RainyDayHiker/splitflap/3d/my_final_stl/Chainlink Driver Mount Left.stl

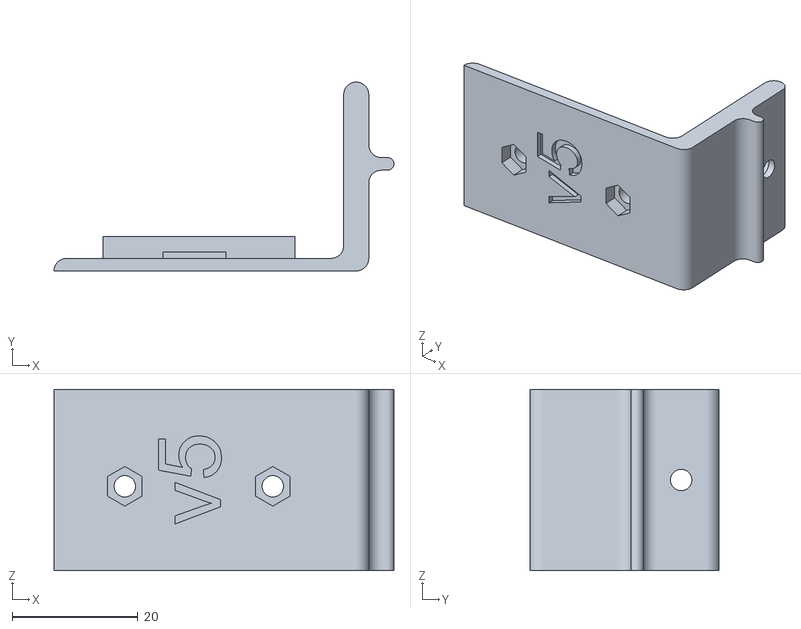
[picture p1: CAD file, 2025-09-09]
3d/my_final_stl/Chainlink Driver Mount Left.stl
54.0 x 30.0 x 28.8
