RainyDayHiker/splitflap/3d/my_final_stl/MainFlaps/flap_00/00_letter_back.stl

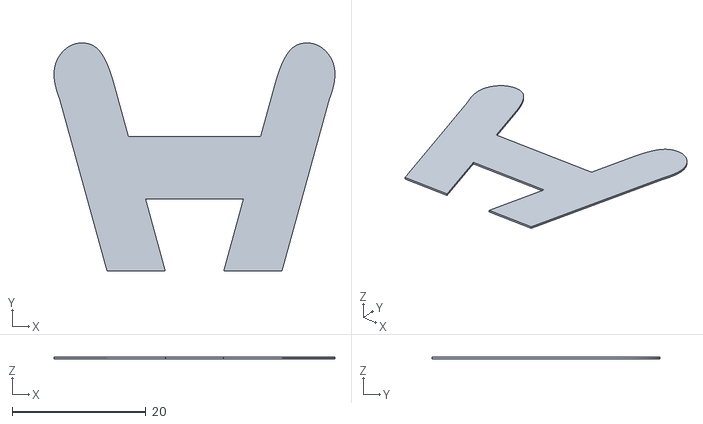
[picture p2: CAD file, 2025-06-13]
3d/my_final_stl/MainFlaps/flap_00/00_letter_back.stl
42.0 x 34.1 x 0.3
