RainyDayHiker/splitflap/3d/my_final_stl/MainFlaps/flap_01/01_letter_front.stl

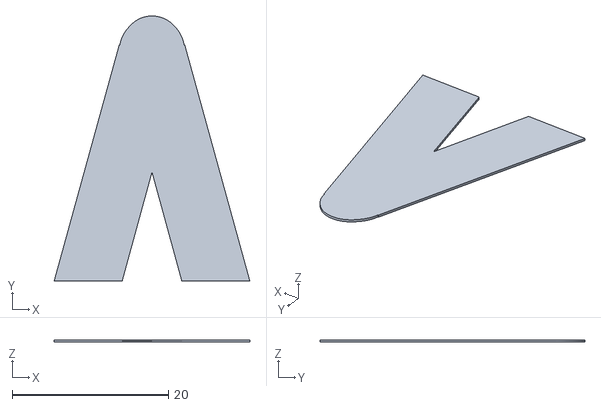
[picture p3: CAD file, 2025-06-13]
3d/my_final_stl/MainFlaps/flap_01/01_letter_front.stl
25.0 x 33.9 x 0.3
