RainyDayHiker/splitflap/3d/my_final_stl/MainFlaps/flap_02/02_flap.stl

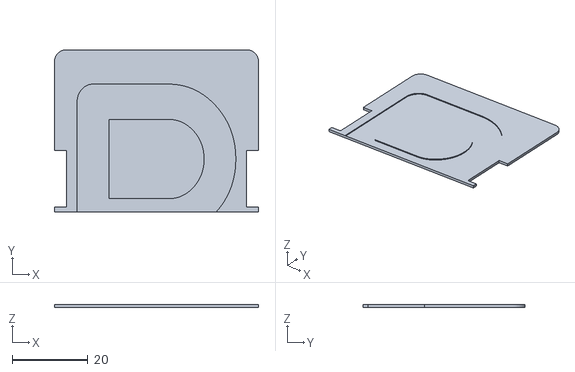
[picture p4: CAD file, 2025-06-13]
3d/my_final_stl/MainFlaps/flap_02/02_flap.stl
54.0 x 43.0 x 0.762
