RainyDayHiker/splitflap/3d/my_final_stl/MainFlaps/flap_03/03_letter_front.stl

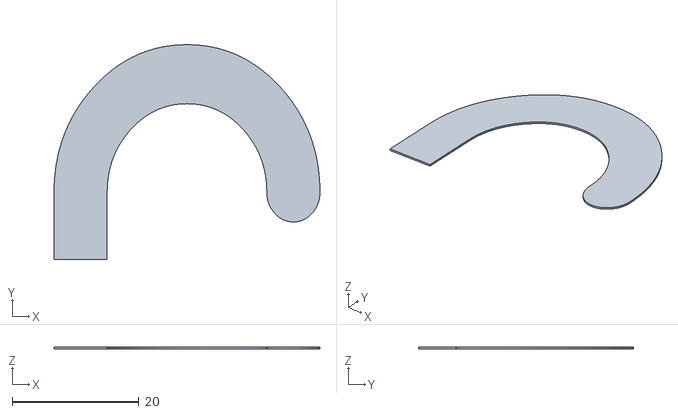
[picture p5: CAD file, 2025-06-13]
3d/my_final_stl/MainFlaps/flap_03/03_letter_front.stl
42.0 x 33.9 x 0.3
