RainyDayHiker/splitflap/3d/my_final_stl/MainFlaps/flap_05/05_letter_back.stl

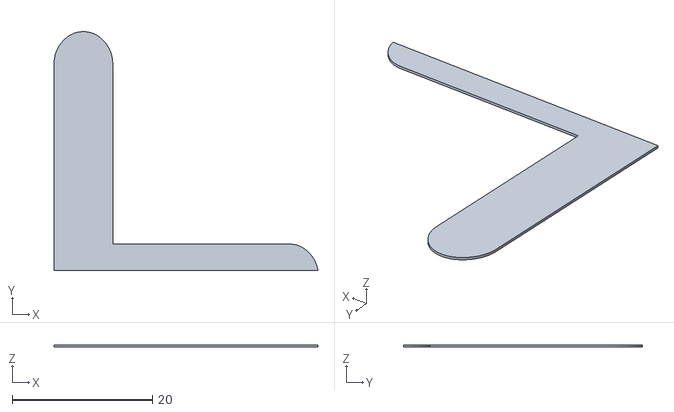
[picture p7: CAD file, 2025-06-13]
3d/my_final_stl/MainFlaps/flap_05/05_letter_back.stl
37.7 x 34.1 x 0.3
