RainyDayHiker/splitflap/3d/my_final_stl/MainFlaps/flap_13/13_letter_back.stl

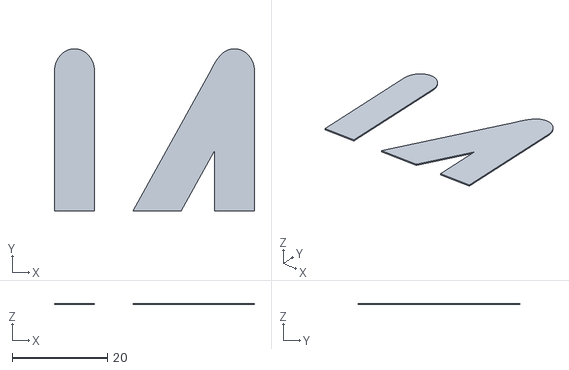
[picture p9: CAD file, 2025-06-13]
3d/my_final_stl/MainFlaps/flap_13/13_letter_back.stl
42.0 x 34.1 x 0.3
