RainyDayHiker/splitflap/3d/my_final_stl/MainFlaps/flap_15/15_letter_back.stl

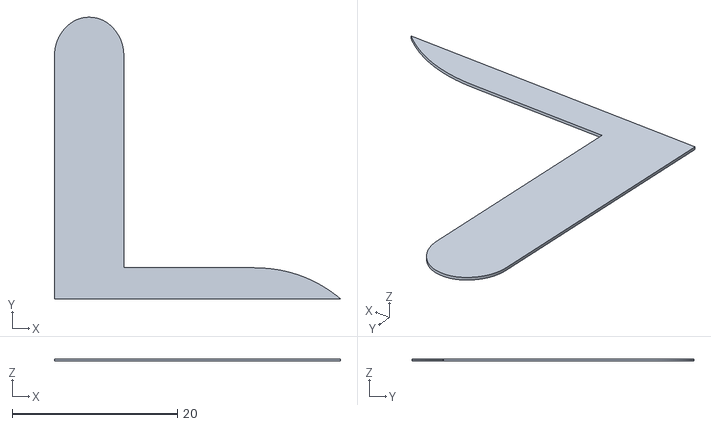
[picture p10: CAD file, 2025-06-13]
3d/my_final_stl/MainFlaps/flap_15/15_letter_back.stl
34.6 x 34.1 x 0.3
