RainyDayHiker/splitflap/3d/my_final_stl/MainFlaps/flap_24/24_letter_back.stl

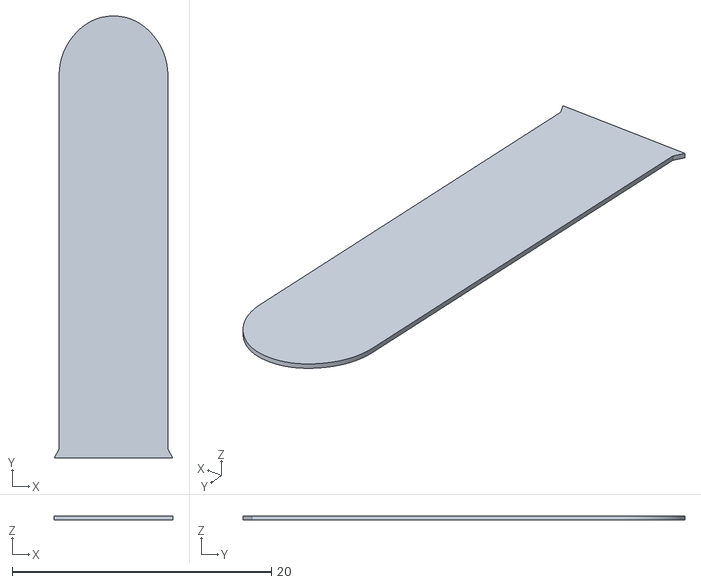
[picture p14: CAD file, 2025-06-13]
3d/my_final_stl/MainFlaps/flap_24/24_letter_back.stl
9.16 x 34.1 x 0.3
