RainyDayHiker/splitflap/3d/my_final_stl/MainFlaps/flap_39/39_letter_back.stl

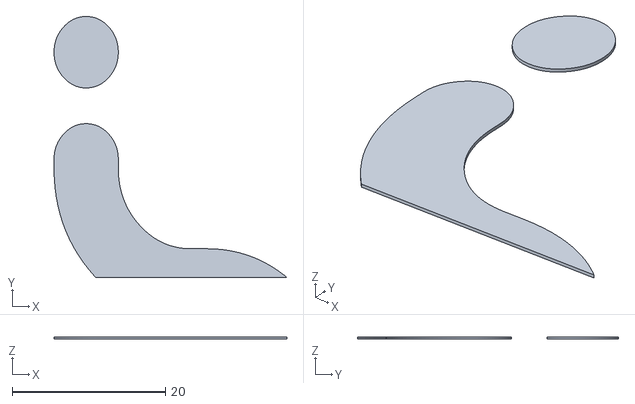
[picture p16: CAD file, 2025-06-13]
3d/my_final_stl/MainFlaps/flap_39/39_letter_back.stl
30.4 x 34.1 x 0.3
