RainyDayHiker/splitflap/3d/my_final_stl/MainFlaps/flap_46/46_letter_back.stl

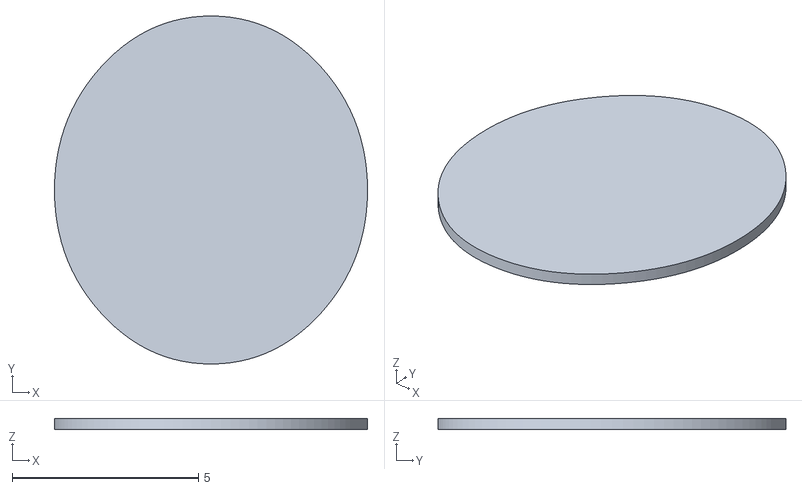
[picture p18: CAD file, 2025-08-20]
3d/my_final_stl/MainFlaps/flap_46/46_letter_back.stl
8.40 x 9.33 x 0.3
