RainyDayHiker/splitflap/3d/my_final_stl/MainFlaps/flap_50/50_letter_back.stl

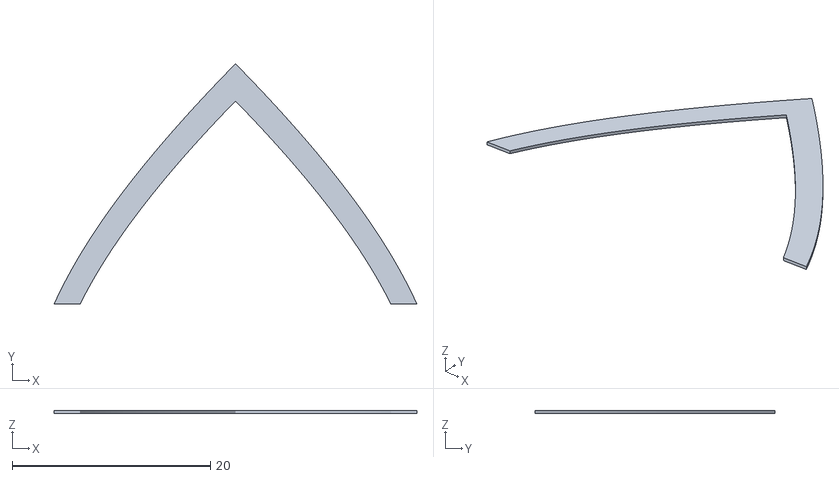
[picture p19: CAD file, 2025-06-13]
3d/my_final_stl/MainFlaps/flap_50/50_letter_back.stl
36.6 x 24.3 x 0.3
