RainyDayHiker/splitflap/3d/my_final_stl/MainFlaps/flaps_printbed_red_x7.3mf

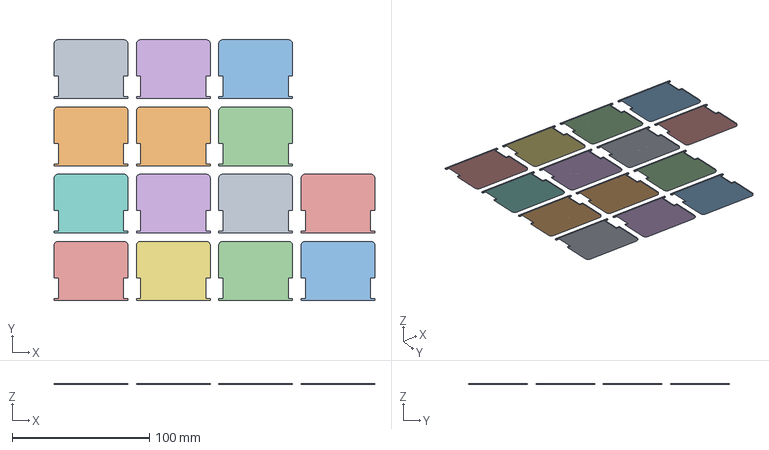
[picture p20: CAD file, 2025-08-25]
3d/my_final_stl/MainFlaps/flaps_printbed_red_x7.3mf
234.0 x 190.0 x 0.782 mm
37_flap
38_flap
