RainyDayHiker/splitflap/3d/my_final_stl/WeatherFlaps/flap_26/26_letter_back.stl

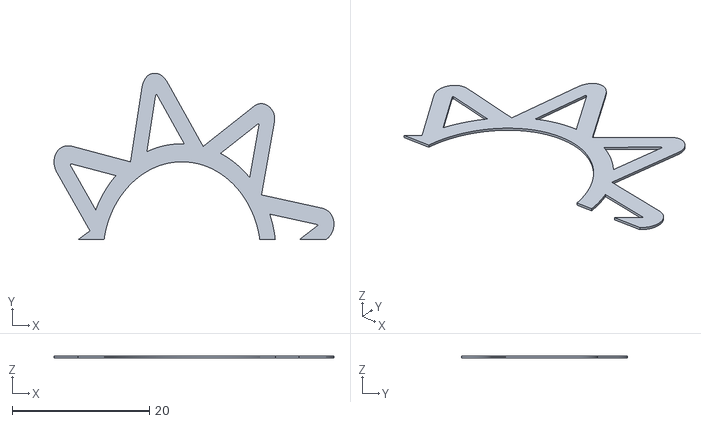
[picture p21: CAD file, 2025-06-13]
3d/my_final_stl/WeatherFlaps/flap_26/26_letter_back.stl
40.8 x 24.3 x 0.3
