RainyDayHiker/splitflap/3d/my_final_stl/WeatherFlaps/flap_37/37_letter_back.stl

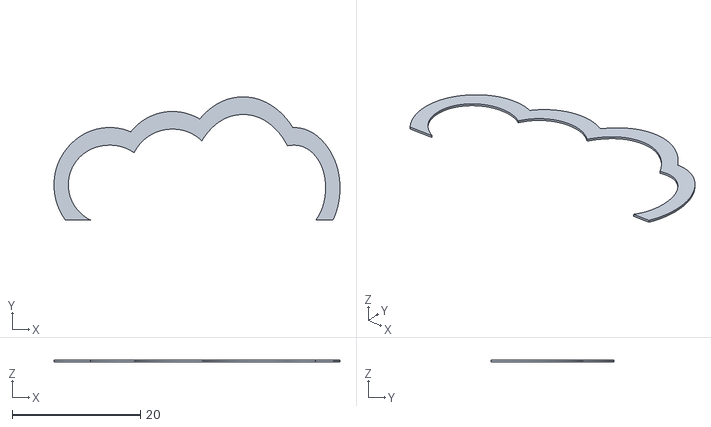
[picture p22: CAD file, 2025-06-13]
3d/my_final_stl/WeatherFlaps/flap_37/37_letter_back.stl
44.7 x 19.3 x 0.3
