RainyDayHiker/splitflap/3d/my_final_stl/WeatherFlaps/flap_45/45_letter_back.stl

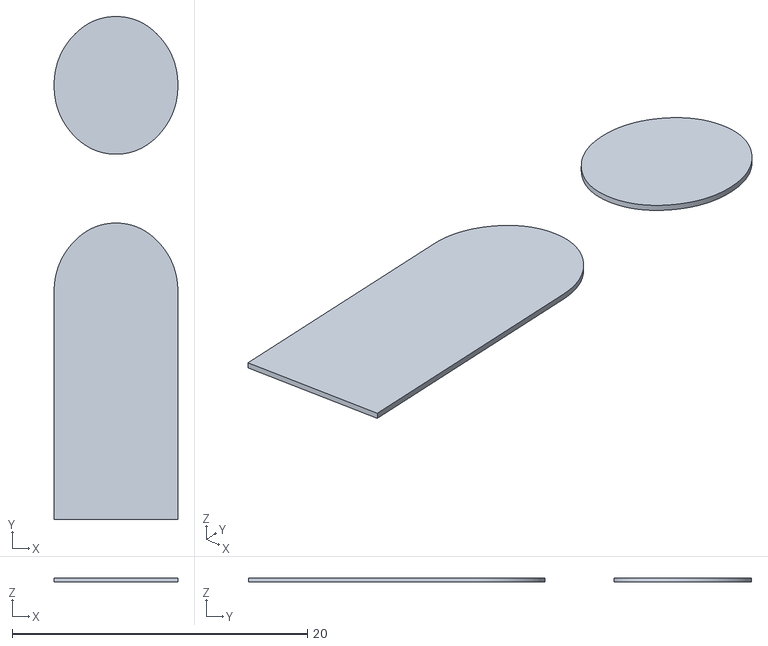
[picture p23: CAD file, 2025-06-13]
3d/my_final_stl/WeatherFlaps/flap_45/45_letter_back.stl
8.40 x 34.1 x 0.3
