RainyDayHiker/splitflap/3d/my_final_stl/WeatherFlaps/flap_48/48_letter_front.stl

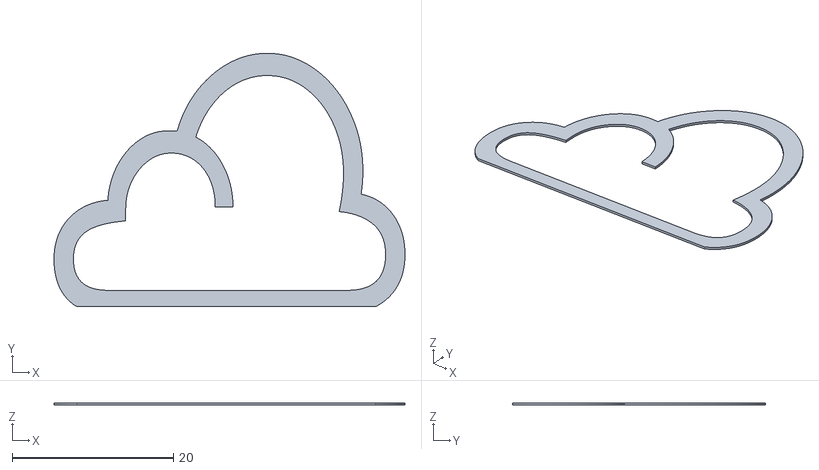
[picture p24: CAD file, 2025-06-13]
3d/my_final_stl/WeatherFlaps/flap_48/48_letter_front.stl
43.5 x 31.4 x 0.3
