RainyDayHiker/splitflap/3d/my_final_stl/WeatherFlaps/flap_49/49_letter_back.stl

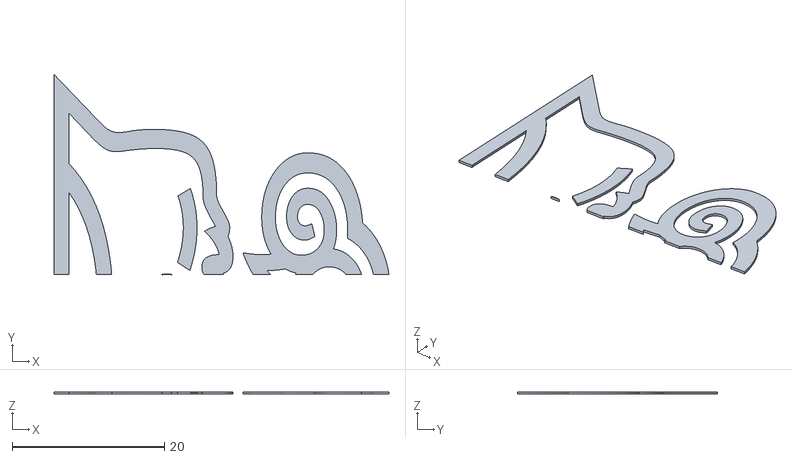
[picture p25: CAD file, 2025-06-13]
3d/my_final_stl/WeatherFlaps/flap_49/49_letter_back.stl
44.0 x 26.3 x 0.3
