RainyDayHiker/splitflap/3d/my_final_stl/WeatherFlaps/flap_50/50_flap.stl

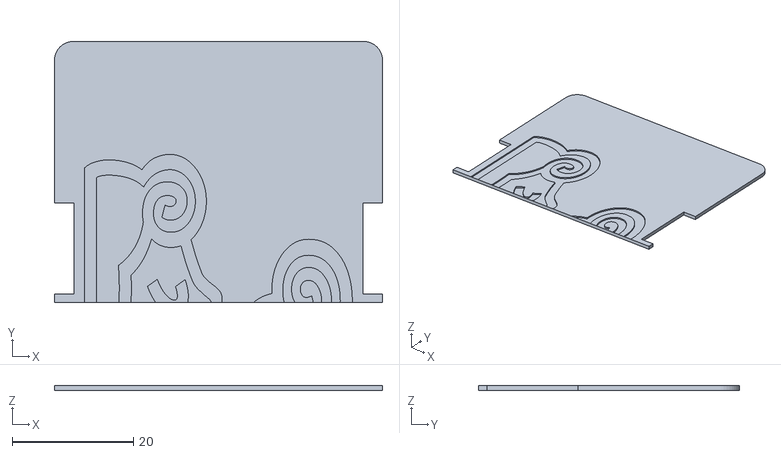
[picture p26: CAD file, 2025-06-13]
3d/my_final_stl/WeatherFlaps/flap_50/50_flap.stl
54.0 x 43.0 x 0.762
