RainyDayHiker/splitflap/3d/my_final_stl/WeatherFlaps/flaps_printbed_2.3mf

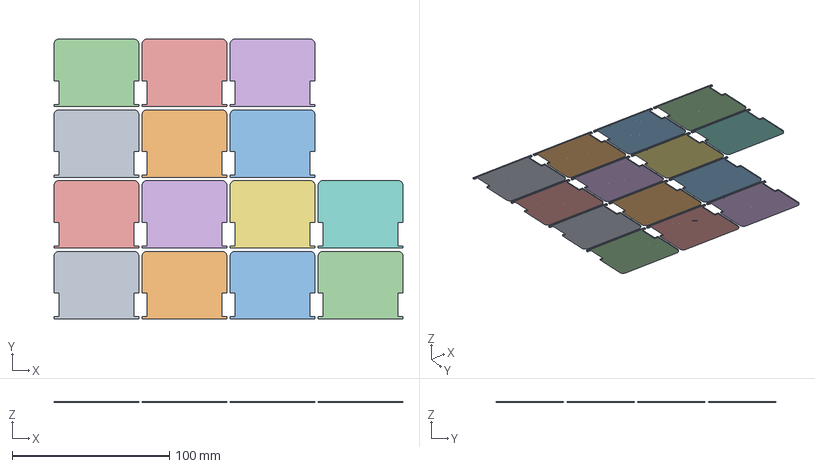
[picture p27: CAD file, 2025-08-20]
3d/my_final_stl/WeatherFlaps/flaps_printbed_2.3mf
222.0 x 178.0 x 0.782 mm
14_flap
15_flap
16_flap
17_flap
18_flap
19_flap
20_flap
21_flap
22_flap
23_flap
24_flap
25_flap
26_flap
27_flap
