RainyDayHiker/splitflap/3d/my_final_stl/Frame - Left.stl

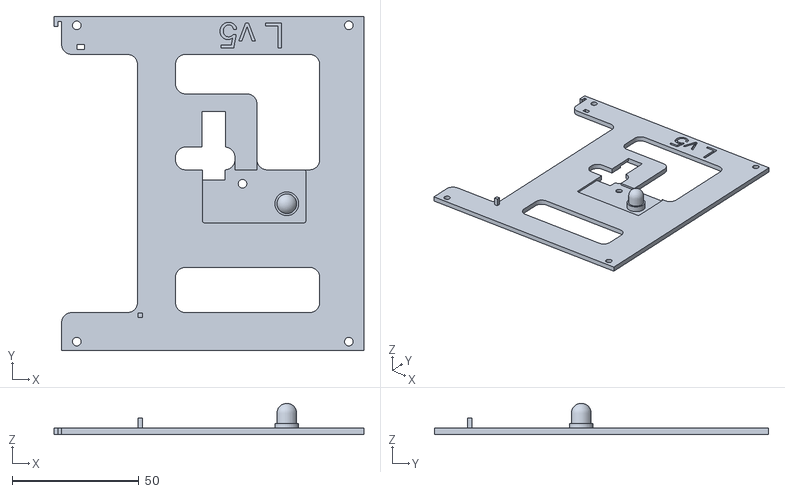
[picture p28: CAD file, 2025-09-09]
3d/my_final_stl/Frame - Left.stl
122.5 x 132.0 x 12.3
