RainyDayHiker/splitflap/3d/my_final_stl/MainFlaps/flap_10/10_letter_front.stl

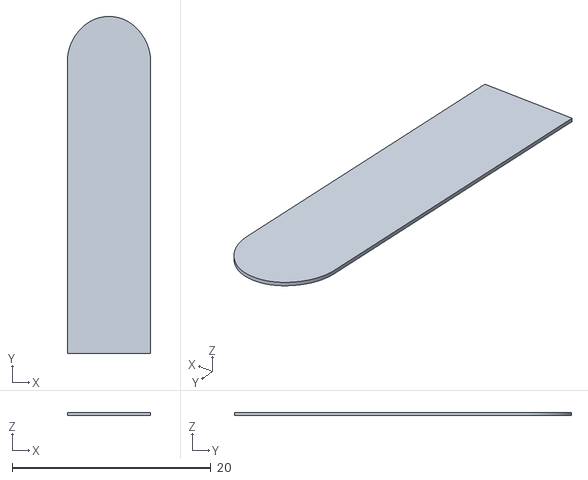
[picture p29: CAD file, 2025-06-13]
3d/my_final_stl/MainFlaps/flap_10/10_letter_front.stl
8.40 x 33.9 x 0.3
