RainyDayHiker/splitflap/3d/my_final_stl/MainFlaps/flap_16/16_letter_back.stl

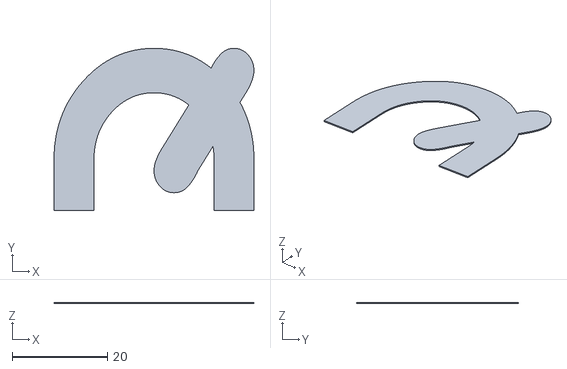
[picture p31: CAD file, 2025-06-13]
3d/my_final_stl/MainFlaps/flap_16/16_letter_back.stl
42.0 x 34.1 x 0.3
