RainyDayHiker/splitflap/3d/my_final_stl/MainFlaps/flap_22/22_letter_back.stl

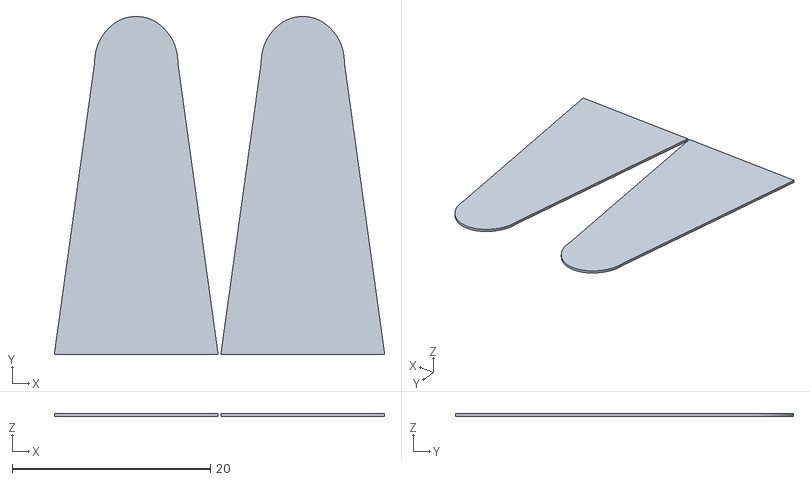
[picture p32: CAD file, 2025-06-13]
3d/my_final_stl/MainFlaps/flap_22/22_letter_back.stl
33.3 x 34.1 x 0.3
