RainyDayHiker/splitflap/3d/my_final_stl/MainFlaps/flap_26/26_letter_back.stl

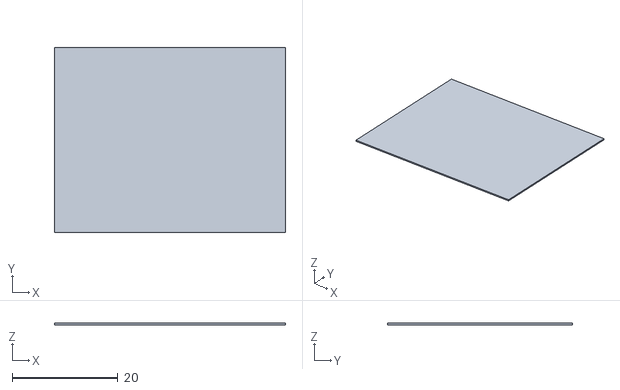
[picture p33: CAD file, 2025-06-13]
3d/my_final_stl/MainFlaps/flap_26/26_letter_back.stl
43.6 x 34.9 x 0.3
