RainyDayHiker/splitflap/3d/my_final_stl/MainFlaps/flap_29/29_letter_front.stl

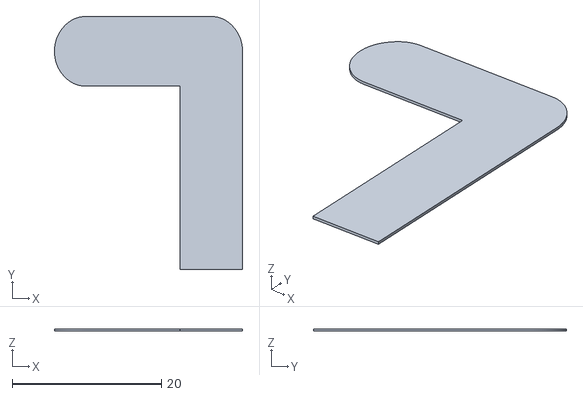
[picture p34: CAD file, 2025-06-13]
3d/my_final_stl/MainFlaps/flap_29/29_letter_front.stl
25.2 x 33.9 x 0.3
