RainyDayHiker/splitflap/3d/my_final_stl/MainFlaps/flap_32/32_letter_front.stl

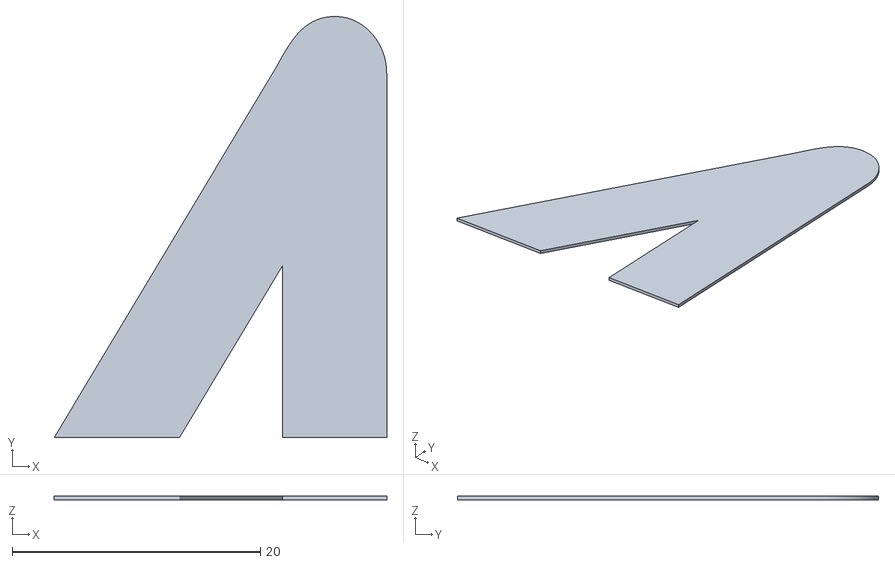
[picture p35: CAD file, 2025-06-13]
3d/my_final_stl/MainFlaps/flap_32/32_letter_front.stl
26.8 x 33.9 x 0.3
