RainyDayHiker/splitflap/3d/my_final_stl/MainFlaps/flap_38/38_letter_front.stl

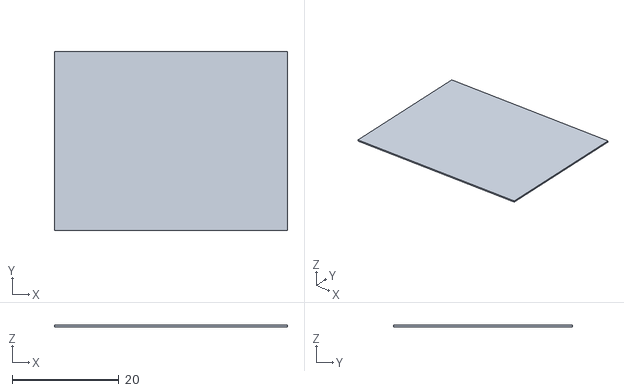
[picture p36: CAD file, 2025-06-13]
3d/my_final_stl/MainFlaps/flap_38/38_letter_front.stl
43.6 x 33.5 x 0.3
