RainyDayHiker/splitflap/3d/my_final_stl/MainFlaps/flap_40/40_letter_back.stl

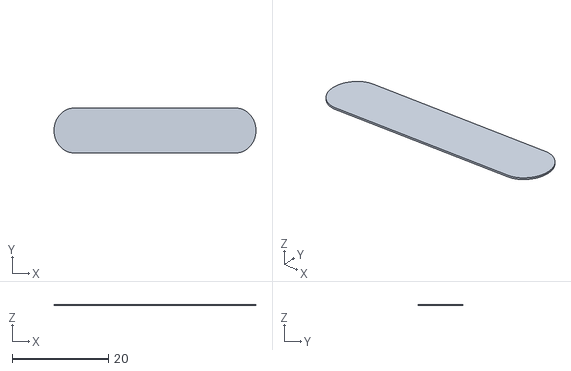
[picture p37: CAD file, 2025-06-18]
3d/my_final_stl/MainFlaps/flap_40/40_letter_back.stl
42.0 x 9.33 x 0.3
