RainyDayHiker/splitflap/3d/flap_characters.scad

// Original
//character_list = " ABCDEFGHIJKLMNOPQRSTUVWXYZg0123456789r.?-$'#yp,!@&w";
// Emoji
character_list = " ABCDEFGHIJKLMNOPQRSTUVWXYZg0123456789r.?-$'#,!:hijk";
// Weather
//character_list = " ABCDEFGHIJKLMNOPQRSTUVWXYZa0123456789b.?-$'#,!:cdef";

function get_character_list() = character_list;
