RainyDayHiker/splitflap/(list of files, cad)

Other CAD files:
3d/my_final_stl/MainFlaps/flap_07/07_letter_back.stl
3d/my_final_stl/MainFlaps/flap_08/08_flap.stl
3d/my_final_stl/MainFlaps/flap_09/09_flap.stl
3d/my_final_stl/MainFlaps/flap_10/10_flap.stl
3d/my_final_stl/MainFlaps/flap_11/11_letter_front.stl
3d/my_final_stl/MainFlaps/flap_12/12_flap.stl
3d/my_final_stl/MainFlaps/flap_14/14_letter_front.stl
3d/my_final_stl/MainFlaps/flap_17/17_letter_front.stl
3d/my_final_stl/MainFlaps/flap_18/18_flap.stl
3d/my_final_stl/MainFlaps/flap_19/19_flap.stl
3d/my_final_stl/MainFlaps/flap_21/21_letter_front.stl
3d/my_final_stl/MainFlaps/flap_22/22_flap.stl
3d/my_final_stl/MainFlaps/flap_25/25_flap.stl
3d/my_final_stl/MainFlaps/flap_26/26_flap.stl
3d/my_final_stl/MainFlaps/flap_27/27_flap.stl
3d/my_final_stl/MainFlaps/flap_28/28_letter_back.stl
3d/my_final_stl/MainFlaps/flap_29/29_flap.stl
3d/my_final_stl/MainFlaps/flap_30/30_flap.stl
3d/my_final_stl/MainFlaps/flap_31/31_flap.stl
3d/my_final_stl/MainFlaps/flap_32/32_flap.stl
3d/my_final_stl/MainFlaps/flap_33/33_letter_back.stl
3d/my_final_stl/MainFlaps/flap_35/35_letter_back.stl
3d/my_final_stl/MainFlaps/flap_36/36_letter_back.stl
3d/my_final_stl/MainFlaps/flap_37/37_letter_front.stl
3d/my_final_stl/MainFlaps/flap_38/38_flap.stl
3d/my_final_stl/MainFlaps/flap_40/40_flap.stl
3d/my_final_stl/MainFlaps/flap_41/41_letter_back.stl
3d/my_final_stl/MainFlaps/flap_42/42_flap.stl
3d/my_final_stl/MainFlaps/flap_43/43_flap.stl
3d/my_final_stl/MainFlaps/flap_44/44_flap.stl
3d/my_final_stl/MainFlaps/flap_47/47_letter_front.stl
3d/my_final_stl/MainFlaps/flap_48/48_flap.stl
3d/my_final_stl/MainFlaps/flap_49/49_flap.stl
3d/my_final_stl/MainFlaps/flap_51/51_flap.stl
3d/my_final_stl/WeatherFlaps/flap_00/00_flap.stl
3d/my_final_stl/WeatherFlaps/flap_02/02_letter_front.stl
3d/my_final_stl/WeatherFlaps/flap_03/03_flap.stl
3d/my_final_stl/WeatherFlaps/flap_04/04_letter_front.stl
3d/my_final_stl/WeatherFlaps/flap_05/05_letter_front.stl
3d/my_final_stl/WeatherFlaps/flap_07/07_flap.stl
3d/my_final_stl/WeatherFlaps/flap_08/08_letter_front.stl
3d/my_final_stl/WeatherFlaps/flap_10/10_flap.stl
3d/my_final_stl/WeatherFlaps/flap_11/11_letter_front.stl
3d/my_final_stl/WeatherFlaps/flap_12/12_flap.stl
3d/my_final_stl/WeatherFlaps/flap_13/13_flap.stl
3d/my_final_stl/WeatherFlaps/flap_14/14_flap.stl
3d/my_final_stl/WeatherFlaps/flap_15/15_letter_front.stl
3d/my_final_stl/WeatherFlaps/flap_16/16_flap.stl
3d/my_final_stl/WeatherFlaps/flap_17/17_letter_front.stl
3d/my_final_stl/WeatherFlaps/flap_18/18_letter_front.stl
3d/my_final_stl/WeatherFlaps/flap_19/19_flap.stl
3d/my_final_stl/WeatherFlaps/flap_20/20_letter_back.stl
3d/my_final_stl/WeatherFlaps/flap_21/21_letter_back.stl
3d/my_final_stl/WeatherFlaps/flap_22/22_flap.stl
3d/my_final_stl/WeatherFlaps/flap_23/23_letter_back.stl
3d/my_final_stl/WeatherFlaps/flap_24/24_flap.stl
3d/my_final_stl/WeatherFlaps/flap_25/25_letter_back.stl
3d/my_final_stl/WeatherFlaps/flap_27/27_flap.stl
3d/my_final_stl/WeatherFlaps/flap_28/28_flap.stl
3d/my_final_stl/WeatherFlaps/flap_29/29_letter_back.stl
3d/my_final_stl/WeatherFlaps/flap_30/30_letter_back.stl
3d/my_final_stl/WeatherFlaps/flap_31/31_flap.stl
3d/my_final_stl/WeatherFlaps/flap_32/32_letter_back.stl
3d/my_final_stl/WeatherFlaps/flap_33/33_letter_front.stl
3d/my_final_stl/WeatherFlaps/flap_35/35_flap.stl
3d/my_final_stl/WeatherFlaps/flap_36/36_letter_front.stl
3d/my_final_stl/WeatherFlaps/flap_38/38_flap.stl
3d/my_final_stl/WeatherFlaps/flap_39/39_flap.stl
3d/my_final_stl/WeatherFlaps/flap_40/40_flap.stl
3d/my_final_stl/WeatherFlaps/flap_41/41_letter_back.stl
3d/my_final_stl/WeatherFlaps/flap_42/42_flap.stl
3d/my_final_stl/WeatherFlaps/flap_43/43_flap.stl
3d/my_final_stl/WeatherFlaps/flap_44/44_flap.stl
3d/my_final_stl/WeatherFlaps/flap_47/47_flap.stl
3d/my_final_stl/WeatherFlaps/flap_51/51_flap.stl
3d/my_final_stl/MainFlaps/flap_00/00_flap.stl
3d/my_final_stl/MainFlaps/flap_01/01_flap.stl
3d/my_final_stl/MainFlaps/flap_02/02_letter_back.stl
3d/my_final_stl/MainFlaps/flap_03/03_letter_back.stl
3d/my_final_stl/MainFlaps/flap_04/04_letter_front.stl
3d/my_final_stl/MainFlaps/flap_05/05_letter_front.stl
3d/my_final_stl/MainFlaps/flap_06/06_flap.stl
3d/my_final_stl/MainFlaps/flap_08/08_letter_back.stl
3d/my_final_stl/MainFlaps/flap_09/09_letter_back.stl
3d/my_final_stl/MainFlaps/flap_11/11_letter_back.stl
3d/my_final_stl/MainFlaps/flap_13/13_flap.stl
3d/my_final_stl/MainFlaps/flap_14/14_flap.stl
3d/my_final_stl/MainFlaps/flap_15/15_flap.stl
3d/my_final_stl/MainFlaps/flap_17/17_letter_back.stl
3d/my_final_stl/MainFlaps/flap_18/18_letter_back.stl
3d/my_final_stl/MainFlaps/flap_19/19_letter_back.stl
3d/my_final_stl/MainFlaps/flap_20/20_flap.stl
3d/my_final_stl/MainFlaps/flap_21/21_flap.stl
3d/my_final_stl/MainFlaps/flap_23/23_flap.stl
3d/my_final_stl/MainFlaps/flap_24/24_letter_front.stl
3d/my_final_stl/MainFlaps/flap_25/25_letter_back.stl
3d/my_final_stl/MainFlaps/flap_27/27_letter_back.stl
3d/my_final_stl/MainFlaps/flap_28/28_letter_front.stl
3d/my_final_stl/MainFlaps/flap_30/30_letter_back.stl
3d/my_final_stl/MainFlaps/flap_31/31_letter_back.stl
3d/my_final_stl/MainFlaps/flap_33/33_flap.stl
3d/my_final_stl/MainFlaps/flap_34/34_flap.stl
3d/my_final_stl/MainFlaps/flap_35/35_flap.stl
3d/my_final_stl/MainFlaps/flap_36/36_flap.stl
3d/my_final_stl/MainFlaps/flap_39/39_flap.stl
3d/my_final_stl/MainFlaps/flap_41/41_flap.stl
3d/my_final_stl/Chainlink Buddy Mount.stl
3d/my_final_stl/Chainlink Driver Mount Right.stl
3d/my_final_stl/Frame - Right.stl
3d/my_final_stl/MainFlaps/flap_01/01_letter_back.stl
3d/my_final_stl/MainFlaps/flap_02/02_letter_front.stl
3d/my_final_stl/MainFlaps/flap_03/03_flap.stl
3d/my_final_stl/MainFlaps/flap_04/04_flap.stl
3d/my_final_stl/MainFlaps/flap_05/05_flap.stl
3d/my_final_stl/MainFlaps/flap_06/06_letter_front.stl
3d/my_final_stl/MainFlaps/flap_07/07_flap.stl
3d/my_final_stl/MainFlaps/flap_08/08_letter_front.stl
3d/my_final_stl/MainFlaps/flap_10/10_letter_back.stl
3d/my_final_stl/MainFlaps/flap_11/11_flap.stl
3d/my_final_stl/MainFlaps/flap_12/12_letter_front.stl
3d/my_final_stl/MainFlaps/flap_13/13_letter_front.stl
3d/my_final_stl/MainFlaps/flap_14/14_letter_back.stl
3d/my_final_stl/MainFlaps/flap_15/15_letter_front.stl
3d/my_final_stl/MainFlaps/flap_16/16_flap.stl
3d/my_final_stl/MainFlaps/flap_17/17_flap.stl
3d/my_final_stl/MainFlaps/flap_18/18_letter_front.stl
3d/my_final_stl/MainFlaps/flap_19/19_letter_front.stl
3d/my_final_stl/MainFlaps/flap_20/20_letter_back.stl
3d/my_final_stl/MainFlaps/flap_21/21_letter_back.stl
3d/my_final_stl/MainFlaps/flap_22/22_letter_front.stl
3d/my_final_stl/MainFlaps/flap_23/23_letter_back.stl
3d/my_final_stl/MainFlaps/flap_24/24_flap.stl
3d/my_final_stl/MainFlaps/flap_25/25_letter_front.stl
3d/my_final_stl/MainFlaps/flap_26/26_letter_front.stl
3d/my_final_stl/MainFlaps/flap_28/28_flap.stl
3d/my_final_stl/MainFlaps/flap_29/29_letter_back.stl
3d/my_final_stl/MainFlaps/flap_30/30_letter_front.stl
3d/my_final_stl/MainFlaps/flap_31/31_letter_front.stl
3d/my_final_stl/MainFlaps/flap_32/32_letter_back.stl
3d/my_final_stl/MainFlaps/flap_33/33_letter_front.stl
3d/my_final_stl/MainFlaps/flap_34/34_letter_front.stl
3d/my_final_stl/MainFlaps/flap_35/35_letter_front.stl
3d/my_final_stl/MainFlaps/flap_36/36_letter_front.stl
3d/my_final_stl/MainFlaps/flap_37/37_flap.stl
3d/my_final_stl/MainFlaps/flap_38/38_letter_back.stl
3d/my_final_stl/MainFlaps/flap_40/40_letter_front.stl
3d/my_final_stl/MainFlaps/flap_42/42_letter_front.stl
3d/my_final_stl/MainFlaps/flap_43/43_letter_back.stl
3d/my_final_stl/MainFlaps/flap_43/43_letter_front.stl
3d/my_final_stl/MainFlaps/flap_44/44_letter_back.stl
3d/my_final_stl/MainFlaps/flap_44/44_letter_front.stl
3d/my_final_stl/MainFlaps/flap_46/46_flap.stl
3d/my_final_stl/MainFlaps/flap_46/46_letter_front.stl
3d/my_final_stl/MainFlaps/flap_47/47_flap.stl
3d/my_final_stl/MainFlaps/flap_47/47_letter_back.stl
3d/my_final_stl/MainFlaps/flap_48/48_letter_back.stl
3d/my_final_stl/MainFlaps/flap_48/48_letter_front.stl
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
