RainyDayHiker/splitflap/firmware/esp32/splitflap/main.cpp

/*
   Copyright 2020 Scott Bezek and the splitflap contributors

   Licensed under the Apache License, Version 2.0 (the "License");
   you may not use this file except in compliance with the License.
   You may obtain a copy of the License at

	   http://www.apache.org/licenses/LICENSE-2.0

   Unless required by applicable law or agreed to in writing, software
   distributed under the License is distributed on an "AS IS" BASIS,
   WITHOUT WARRANTIES OR CONDITIONS OF ANY KIND, either express or implied.
   See the License for the specific language governing permissions and
   limitations under the License.
*/

#include <Arduino.h>
#include <TFT_eSPI.h>
#include <Wire.h>
#include <LittleFS.h>

#include "config.h"

#include "../core/configuration.h"
#include "../core/splitflap_task.h"
#include "debug_build_info.h"
#include "display_task.h"
#include "serial_task.h"
#include "../app/app.h"

Configuration config;

SplitflapTask splitflapTask(1, LedMode::AUTO);
SerialTask serialTask(splitflapTask, 0);

#if ENABLE_DISPLAY
DisplayTask displayTask(splitflapTask, 0);
#endif

#ifdef CHAINLINK_BASE
#include "../base/base_supervisor_task.h"
BaseSupervisorTask baseSupervisorTask(splitflapTask, serialTask, 0);
#endif

#if MQTT
#include "mqtt_task.h"
MQTTTask mqttTask(splitflapTask, displayTask, serialTask, 0);
#endif

#if HTTP
#include "http_task.h"
HTTPTask httpTask(splitflapTask, displayTask, wifiTask, serialTask, 0);
#endif

App app(splitflapTask, displayTask, serialTask);

void setup()
{
	serialTask.begin();
	serialTask.setLogInterface(&app);

	if (!LittleFS.begin(false /*FORMAT_LITTLEFS_IF_FAILED*/))
	{
		serialTask.log("LittleFS Mount Failed");
		delay(10000);
		return;
	}

	config.setLogger(&serialTask);
	bool loaded = config.loadFromDisk();

	splitflapTask.begin();
	splitflapTask.setConfiguration(&config);

	uint16_t offsets[NUM_MODULES] = {};
	if (loaded)
	{
		PB_PersistentConfiguration saved = config.get();
		for (uint8_t i = 0; i < min(saved.module_offset_steps_count, (pb_size_t)NUM_MODULES); i++)
			offsets[i] = saved.module_offset_steps[i];
	}
	else if (NUM_MODULES >= 6)
	{
		serialTask.log("No saved config - using custom default offsets");
		for (uint8_t i = 0; i < NUM_MODULES; i++)
			offsets[i] = default_offsets[i];
	}
	splitflapTask.restoreAllOffsets(offsets);

#if ENABLE_DISPLAY
	displayTask.begin();
#endif

#if MQTT
	mqttTask.begin();
#endif

#if HTTP
	httpTask.begin();
#endif

#ifdef CHAINLINK_BASE
	baseSupervisorTask.begin();
#endif

	app.begin();

	logDebugBuildInfo(serialTask);

	// Delete the default Arduino loopTask to free up Core 1
	vTaskDelete(NULL);
}

void loop()
{
	assert(false);
}
