RainyDayHiker/splitflap/(commit log)

2025-06-13 Add script (written by Copilot) to lay out flap print beds for PrusaSlicer
2025-06-13 Start of code changes - reverse motor direction and enable HTTP (but comment out request since it just fails)
    [http_task.cpp]
2025-06-13 Add Instruction and NotoEmoji fonts and setup my flap sets
    [flap.scad, flap_characters.scad, flap_fonts.scad]
2025-06-13 Add current STLs
    [00_flap.stl, 00_letter_back.stl, 01_flap.stl, 01_letter_back.stl, 01_letter_front.stl, 02_flap.stl, 02_letter_back.stl, 02_letter_front.stl]
2025-06-18 Flip odd numbered flaps and provide a max number of flaps per bed
2025-06-18 Tweaks to a few characters
    [flap.scad, flap_fonts.scad]
2025-06-18 Characters updates part 2
    [flap.scad, flap_fonts.scad]
2025-06-18 Updates to main STL files
    [Left Plate 2x.3mf, Not a Mount.stl, Right Plate 2x.3mf, splitflap.f3d]
2025-06-18 Update flaps with latest generation
    [10_flap.stl, 19_flap.stl, 26_flap.stl, 27_flap.stl, 37_flap.stl, 38_flap.stl, 40_flap.stl, 40_letter_back.stl]
2025-06-19 Small tweak to characters
    [12_flap.stl, 26_flap.stl, 37_flap.stl, 38_flap.stl, 40_flap.stl, 43_flap.stl, 44_flap.stl, 44_letter_back.stl]
2025-07-06 Update bed layout script
2025-07-06 Update STLs
    [10_flap.stl, 12_flap.stl, 19_flap.stl, 37_flap.stl, 38_flap.stl, 40_flap.stl, 43_flap.stl, 44_flap.stl]
2025-07-08 Updated printbeds to pull the red/green flaps into their own beds to be efficient
    [flaps_printbed_1.3mf, flaps_printbed_2.3mf, flaps_printbed_3.3mf, flaps_printbed_4.3mf, flaps_printbed_4_x2.3mf, flaps_printbed_green_x7.3mf, flaps_printbed_red_x7.3mf]
2025-08-20 Swap & for :
    [flap_characters.scad, flap_fonts.scad]
2025-08-20 Update to current STL set
    [46_flap.stl, 46_letter_back.stl, 46_letter_front.stl, 47_flap.stl, 47_letter_back.stl, 47_letter_front.stl, Chainlink Buddy Mount.stl, Chainlink Driver Mount Left.stl]
2025-08-25 More updates to STLs
    [Panel - Back - Buddy Left.stl, Panel - Back - Buddy Right.stl, Panel - Back - Buddy.stl, Panel - Back.stl, Panel - Left.stl, Spool - Left.stl, Spool - Right.stl, flaps_printbed_red_x7.3mf]
2025-08-29 Finish support for LittleFS
    [configuration.h]
2025-08-29 Tweaks to build
    [Panel - Right.stl]
2025-09-08 Upgrade expressif32 to 6, update wifi and webserver tasks - webserver seems broken but everything else seems to be working
    [configuration.h, partitions_custom.csv]
2025-09-09 Finalize getting wifi configuration correct
    [logger.h, wifi_task.cpp, wifi_task.h]
2025-09-09 Update STL files
    [Chainlink Buddy Mount.stl, Chainlink Driver Mount Left.stl, Chainlink Driver Mount Right.stl, Frame - Left.stl, Frame - Right.stl, Frames.3mf, Panel - Back - Buddy.stl, Panel - Back.stl]
2025-09-09 printing note update
2025-09-09 Update config to correct character set
    [config.h]
2025-09-09 Revert http_task changes back to baseline since I'm not going to use this code
    [http_task.cpp, http_task.h]
2025-09-10 More print notes
2025-09-10 Fix quiet time calculation and add a big switch to turn off auto updates (useful for development - especially in building the hardware out)
2025-09-13 Add flap home offset to the cached state object for later exposure (note: diff is large due to pretty print changes)
2025-09-17 WiFi TxPower tweak for new ESP32 board
2025-09-17 Another small tweak for the ESP32 board to prevent a restart when disconnecting the serial monitor
2025-09-18 Tweak wifi power again
2025-10-23 Add OTA update support
    [partitions_custom.csv]
2025-11-27 Update fusion file
    [Split Flap.f3d]
2026-04-15 Enhance SplitFlap functionality with improved logging and error handling for command queuing
    [splitflap_task.cpp]
